ThijmenFickweiler/OpenTI/hardware/manufacturing/OpenTI-84-BOM.csv

ID | Name | Designator | Footprint | Quantity | Manufacturer Part | Manufacturer | Supplier | Supplier Part | Price
1 | 22uF | C3,C8 | C0603 | 2 | CL10A226MP8NUNE | SAMSUNG(三星) | LCSC | C86295 | 0.033
2 | AO3401A_C347476 | Q10 | SOT-23_L2.9-W1.3-P1.90-LS2.4-BR | 1 | AO3401A | UMW(友台半导体) | LCSC | C347476 | 0.032
3 | APFA2507LQBDSEEZGKC | U10 | LED-SMD_4P-L2.5-W1.0_APFA2507LQBDSEEZGKC | 1 | APFA2507LQBDSEEZGKC | Kingbright(今台) | LCSC | C5126857 | 0.769
4 | 100nF | C1,C2,C6,C48,C5,C7 | C0402 | 6 | CC0402KRX7R7BB104 | YAGEO(国巨) | LCSC | C60474 | 0.005
5 | USBLC6-2SC6 | D1 | SOT-23-6_L2.9-W1.6-P0.95-LS2.8-BL | 1 | USBLC6-2SC6 | ST(意法半导体) | LCSC | C7519 | 0.182
6 | XL-1608UGC-04 | LED1,LED3 | LED0603-RD_GREEN | 2 | XL-1608UGC-04 | XINGLIGHT(成兴光) | LCSC | C965804 | 0.005
8 | 10kΩ | R2,R54,R11,R12,R13,R16,R21,R29,R31,R32,R33,R35,R36,R38,R39,R40,R41,R42,R43,R44,R45,R46,R47,R48,R49,R50,R51,R52,R53,R55,R56,R57,R58,R59,R60,R61,R62,R63,R64,R65,R66,R67,R68,R69,R70,R71,R72,R73,R74,R75,R76,R77,R78,R79,R80,R81,R82,R83,R84,R85 | R0402 | 60 | RC0402FR-0710KL | YAGEO(国巨) | LCSC | C60490 | 0.002
9 | 1kΩ | R3,R34,R5,R6,R7,R15,R18 | R0402 | 7 | RC0402FR-071KL | YAGEO(国巨) | LCSC | C106235 | 0.003
10 | 15kΩ | R4,R14 | R0603 | 2 | ARG03DTC1502 | Viking(光颉) | LCSC | C311912 | 0.009
11 | 22Ω | R9,R10,R25,R26,R27,R28 | R0402 | 6 | RC0402FR-0722RL | YAGEO(国巨) | LCSC | C114765 | 0.002
12 | ESP32-S3-WROOM-1(N16) | U1 | WIRELM-SMD_ESP32-S3-WROOM-1 | 1 | ESP32-S3-WROOM-1-N16 | ESPRESSIF(乐鑫) | LCSC | C2913199 | 5.002
13 | TPS631000DRLR | U2 | SOT-583-8_L2.1-W1.2-P0.50-LS1.6-BL | 1 | TPS631000DRLR | TI(德州仪器) | LCSC | C5219190 | 0.474
14 | GT-BTP30003-0540A-016A | U3 | CONN-SMD_GT-BTP30003-0540A-016A | 1 | GT-BTP30003-0540A-016A | G-Switch(品赞) | LCSC | C41378739 | 0.307
15 | BQ24075RGTT | U4 | VQFN-16_L3.0-W3.0-P0.50-TL-EP1.7 | 1 | BQ24075RGTT | TI(德州仪器) | LCSC | C2865459 | 1.269
16 | 4.7uF | U5,U6,U8 | C0402 | 3 | HGC0402R5475K100NTEJ | Chinocera(华瓷) | LCSC | C7472956 | 0.009
17 | ESD56281N05-2/TR | U7 | DFN1006-2L-RD | 1 | ESD56281N05-2/TR | WILLSEMI(韦尔) | LCSC | C5140547 | 0.034
18 | 1uH | U9 | L1008 | 1 | DFE252012P-1R0M=P2 | muRata(村田) | LCSC | C882955 | 0.12
19 | 1uF | U41 | C0402 | 1 | TCC0402X5R105M6R3AT | CCTC(三环) | LCSC | C2887021 | 0.004
20 | MINI 5PTP | USB1 | MINI-USB-SMD_MINI-5PTP | 1 | MINI 5PTP | SHOU HAN(首韩) | LCSC | C2681563 | 0.07
21 | AFC01-S18FCC-00 | FPC1 | FPC-SMD_AFC01-S18FCC-00 | 1 | AFC01-S18FCC-00 | JS(钜硕电子) | LCSC | C262273 | 0.103
22 | MMBT2222A_C727131 | Q11 | SOT-23-3_L2.9-W1.4-P1.91-LS2.6-BR | 1 | MMBT2222A | TWGMC(迪嘉) | LCSC | C727131 | 0.015
23 | 4.7kΩ | R17,R37 | R0402 | 2 | RC0402FR-074K7L | YAGEO(国巨) | LCSC | C105871 | 0.002
24 | 511kΩ | R19 | R0402 | 1 | RC0402FR-07511KL | YAGEO(国巨) | LCSC | C163461 | 0.002
25 | 91kΩ | R20 | R0402 | 1 | FRC0402F9102TS | FOJAN(富捷) | LCSC | C2909393 | 0.001
26 | 750Ω | R22 | R0402 | 1 | FRC0402F7500TS | FOJAN(富捷) | LCSC | C2909382 | 0.001
27 | 330Ω | R23,R24 | R0402 | 2 | 0402WGF3300TCE | UNI-ROYAL(厚声) | LCSC | C25104 | 0.001
28 | FCA9535T | U11,U12 | TSSOP-24_L7.8-W4.4-P0.65-LS6.4-BL | 2 | FCA9535T | Nyfea(徕飞) | LCSC | C55318344 | 0.395
29 | BX-TS-26-392932T | U13,U14 | KEY-SMD_L3.9-W3.0-LS5.0 | 2 | BX-TS-26-392932T | Bossie(博锡) | LCSC | C18077674 | 0.037
