ThijmenFickweiler/OpenTI/hardware/mechanical/OpenTI-84-DXF-REV2.dxf

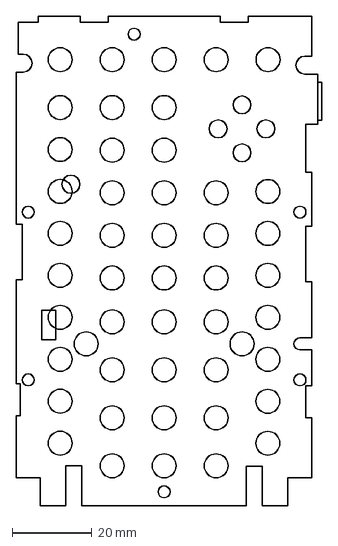
[picture p5: CAD file, 2026-10-27]
hardware/mechanical/OpenTI-84-DXF-REV2.dxf
76.6 x 122.5 mm
