ThijmenFickweiler/OpenTI/(list of files, drawings)

Other design files:
hardware/easyeda/OpenTI-84-EasyEDA-PCB.json
hardware/easyeda/OpenTI-84-EasyEDA-SCH.json
