ThijmenFickweiler/OpenTI/(commit log)

2026-10-27 Added devlog 1&2 images and mainboard layout
    [OpenTI DXF REV2.dxf]
2026-11-01 Reorder of all files
    [OpenTI-84-BOM.csv, OpenTI-84-DXF-REV2.dxf, OpenTI-84-EasyEDA-PCB.json, OpenTI-84-EasyEDA-SCH.json]
